vn-ntd/riscv_picorv32_sky130_asic_flow/reports/metrics.csv

design | design_name | config | flow_status | total_runtime | routed_runtime | (Cell/mm^2)/Core_Util | DIEAREA_mm^2 | CellPer_mm^2 | OpenDP_Util | Final_Util | Peak_Memory_Usage_MB | synth_cell_count | tritonRoute_violations | Short_violations | MetSpc_violations | OffGrid_violations | MinHole_violations | Other_violations | Magic_violations | pin_antenna_violations | net_antenna_violations | lvs_total_errors | cvc_total_errors | klayout_violations | wire_length | vias | wns | pl_wns | optimized_wns | fastroute_wns | spef_wns | tns | pl_tns | optimized_tns | fastroute_tns | spef_tns | HPWL | routing_layer1_pct | routing_layer2_pct | routing_layer3_pct | routing_layer4_pct | routing_layer5_pct | routing_layer6_pct | wires_count | wire_bits | public_wires_count | public_wire_bits | memories_count | memory_bits | processes_count | cells_pre_abc | AND | DFF | NAND | NOR | OR | XOR | XNOR | MUX
/openlane/designs/picorv32_custom | picorv32 | run_final_68util_7p5ns | flow completed | 0h26m34s0ms | 0h24m27s0ms | 102326.24435931748 | 0.1605878633 | 69581.84616433589 | 69.93 | -1 | 1092.1 | 9442 | 0 | 0 | 0 | 0 | 0 | 0 | 0 | 22 | 21 | 0 | -1 | -1 | 511143 | 91385 | 0.0 | -1 | -1 | -1 | 0.0 | 0.0 | -1 | -1 | -1 | 0.0 | 332920878.0 | 0.0 | 62.0 | 70.4 | 33.54 | 48.85 | 2.07 | 6301 | 8874 | 179 | 2304 | 0 | 0 | 0 | 8116 | 398 | 91 | 225 | 173 | 1045 | 388 | 113 | 2709
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
