vn-ntd/riscv_picorv32_sky130_asic_flow/(commit log)

2026-10-17 Initial commit: Full-flow ASIC implementation of 32-bit RISC-V on SkyWater 130nm
2026-10-19 Comprehensive refinement: fix timing breakdown, add multi-corner STA, power report, verification testbench, CI workflow, and LICENSE
2026-10-19 fix(ci): strip UTF-8 BOM from Verilog source and scripts to fix iverilog compilation
2026-10-19 docs & flow: resolve all remaining review critiques (antenna transparency, STA derating, die/core clarity, portable run_flow, and GLS support)
2026-10-26 feat(sw): add C/assembly firmware environment, dynamic hex loading, and master Makefile
2026-10-26 feat(signoff): add multi-corner STA sweep, power grid IR-drop analysis, and SDF generation
2026-10-26 feat(tapeout): add Caravel SoC Wishbone wrapper, formal antenna waiver, and tapeout validation
