vn-ntd/riscv_picorv32_sky130_asic_flow/(notices)

Notices in the files:
README.md:
License: Apache 2.0 / ISC
